AFN2760/12V-to-5V-and-12V-to-18V-Buck-Boost-DC-DC-Converter/Hardware/Screenshot 2026-05-31 173947.png

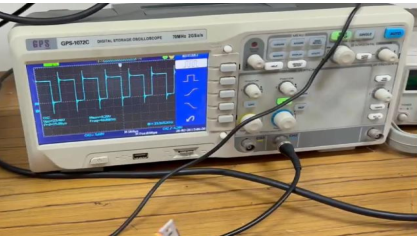
Hardware/Screenshot 2026-05-31 173947.png
