AFN2760/12V-to-5V-and-12V-to-18V-Buck-Boost-DC-DC-Converter/(list of files, drawings)

Other design files:
Simulation/powerelectronics.pdsprj
